titmouse001/AY-3-8910-PSG-MusicPlayer-VU-Meter/AY-3-8910-PSG-MusicPlayerREWORKED/Pictures_Prototyping/Schematic_AY-Player reworked nano_2023-01-25.png

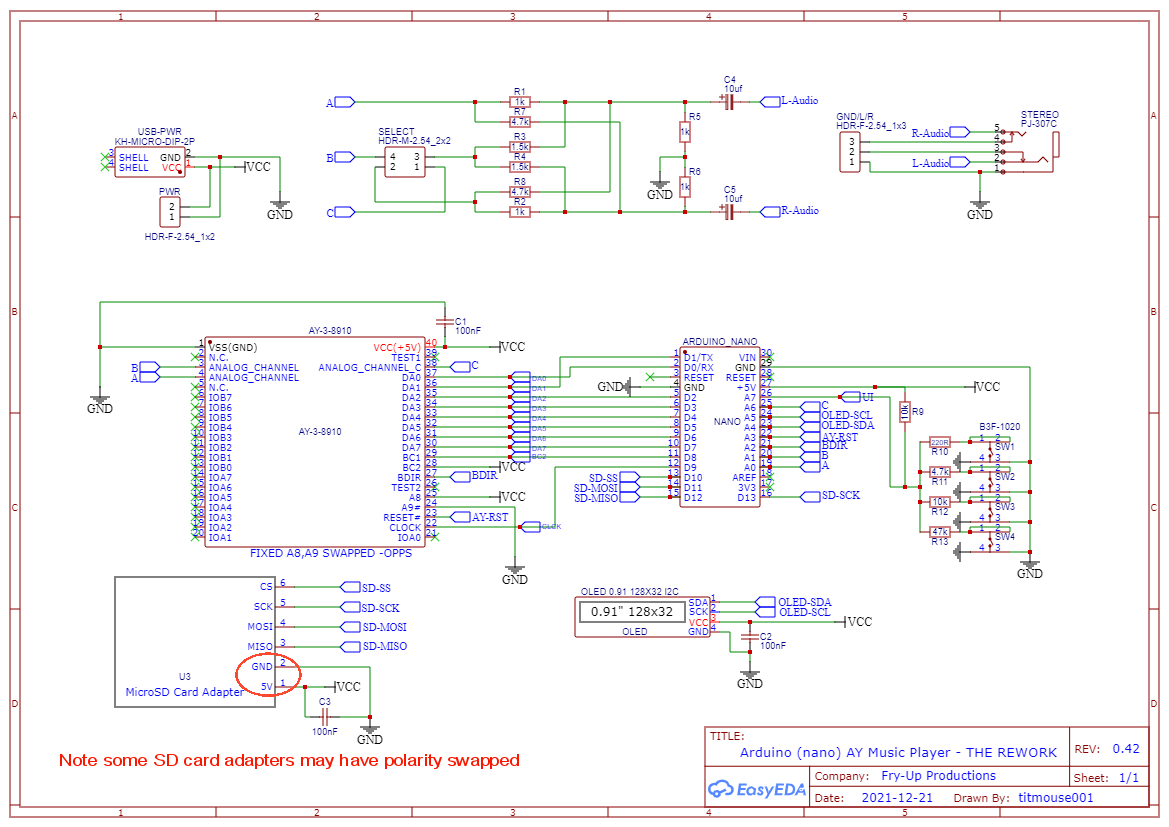
AY-3-8910-PSG-MusicPlayerREWORKED/Pictures_Prototyping/Schematic_AY-Player reworked nano_2023-01-25.png
