titmouse001/AY-3-8910-PSG-MusicPlayer-VU-Meter/(commit log)

2022-07-21 74HC595 gone, SdFat.h gone
    Hardware has been rewired, losing the 74HC595 Serial to Parallel Shifting to use the data lines directly.
    Replaced <SdFat.h> with <SD.h> as having issues with LGT8F328P as an Arduino clone.
    [AY-3-8910-PSG-MusicPlayerREWORKED.ino]
2022-07-23 Update AY-3-8910-PSG-MusicPlayerREWORKED.ino
    Added next/back tune
    Fix bug - close the %$@#! file
    (moved methods about - coz I like making compare on commit harder)
    [AY-3-8910-PSG-MusicPlayerREWORKED.ino]
2022-07-24 Update AY-3-8910-PSG-MusicPlayerREWORKED.ino
    - Added some notes.
    - Noted that D0,A0 are only part of the LGT8F328P build environment, switching to say Nano breaks build - added ifndef defines
2022-07-24 fix missing wait on FE/FF
    - Fixed PSG FF/FE's not doing the wait command.
    - Filename clears all the way.
    - Move clutter to h files.
    [AY-3-8910-PSG-MusicPlayerREWORKED.ino, AY3891xRegisters.h, pins.h]
2022-07-29 UV meter rework
    Trying something new, reading the audio back in via ADC for the VU meter.
    Looks ok, better than faking via tune data
    [AY-3-8910-PSG-MusicPlayerREWORKED.ino, pins.h]
2022-07-30 Update AY-3-8910-PSG-MusicPlayerREWORKED.ino
    Audio VU meter now use a mean value calculated and handed over at interrupt time
2022-12-19 Update AY-3-8910-PSG-MusicPlayerREWORKED.ino
    bug fix :removed odd code loop from selectFile, maybe old debug code!?!?!
    [AY-3-8910-PSG-MusicPlayerREWORKED.ino]
2023-03-24 VU with LED's
    Adding VU LED's - testing PCB with port A first - WORKS!!!
2023-03-29 minor features added
    Completed to do list, moved sections about, small rework / minor tweaks.
    [AY-3-8910-PSG-MusicPlayerREWORKED.ino, pins.h]
2024-11-19 Update AY-3-8910-PSG-MusicPlayerREWORKED.ino
    Reduced memory footprint, reusing file root for reading temp file later on!
2025-01-29 Refactoring
    Codes getting messy again... time to redo the ugly prototype bits!
2025-01-29 Update AY-3-8910-PSG-MusicPlayerREWORKED.ino
    Fixed refresh bug - flag reset to early
    Deleted all commented out code.
    [AY-3-8910-PSG-MusicPlayerREWORKED.ino]
2025-01-30 small rework
    Moved some vars into the main mask flag
    Refactored main loop
    [AY-3-8910-PSG-MusicPlayerREWORKED.ino]
2025-01-30 added latest Gerber
    Copied my last PCB order from JLCPCB site, they keep Gerber files for re-orders.
    Look on PCB back, should read v2.1
